oprobst/compressor-monitor/Dokumentation/Füllanlage-legende.png

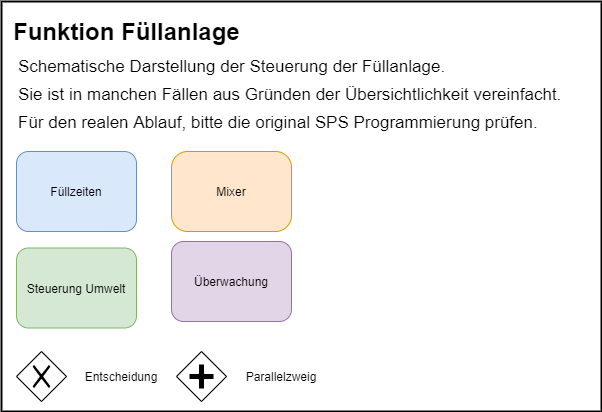
Dokumentation/Füllanlage-legende.png
