oprobst/compressor-monitor/Dokumentation/Füllanlage-steuerung.png

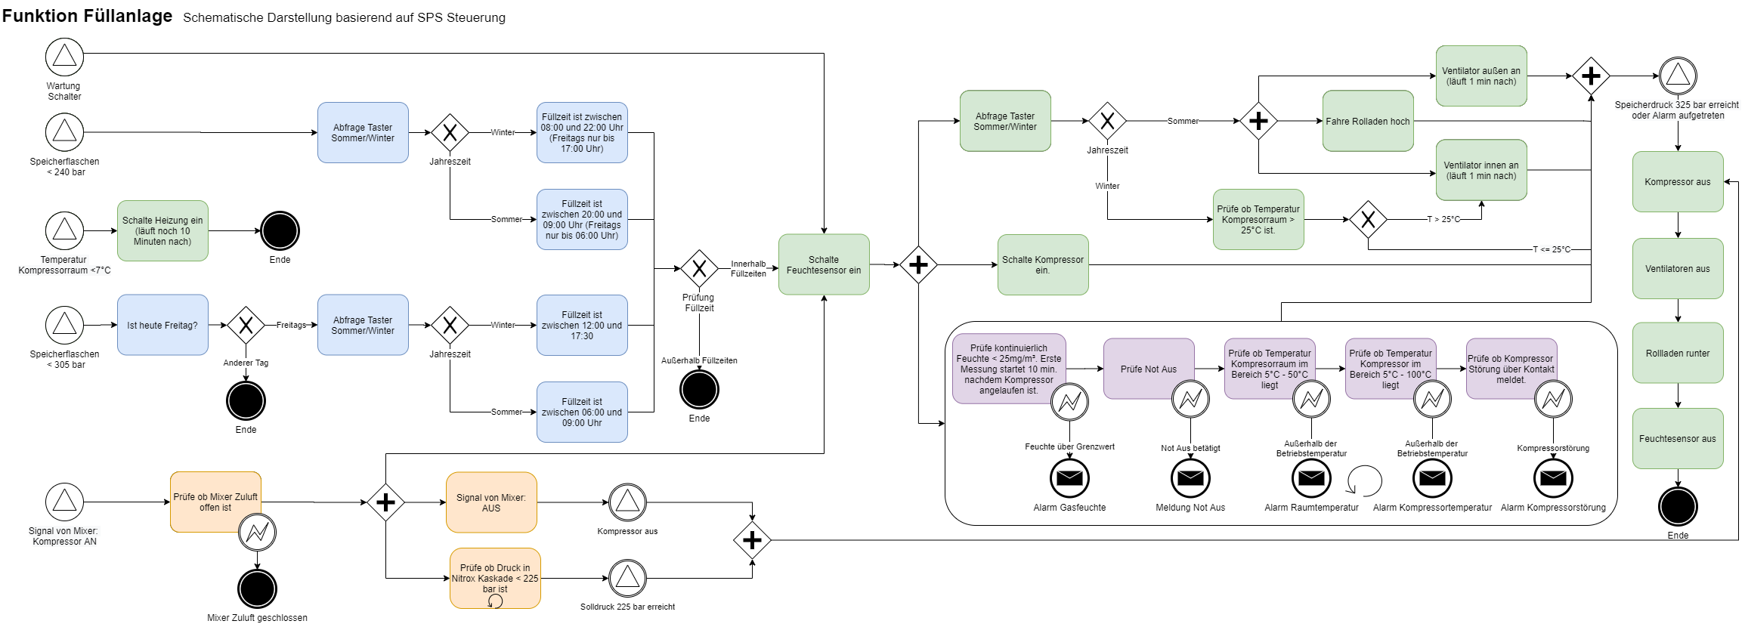
Dokumentation/Füllanlage-steuerung.png
