oprobst/compressor-monitor/Dokumentation/Schaltplan-Kompressor-Abschaltung.png

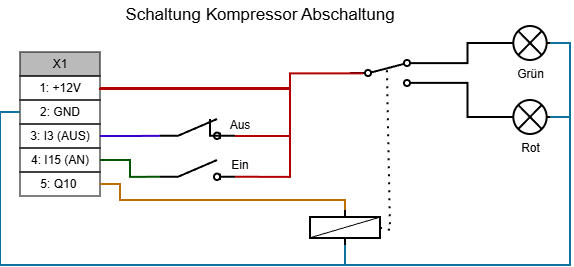
Dokumentation/Schaltplan-Kompressor-Abschaltung.png
