oprobst/compressor-monitor/Dokumentation/Schaltplan_Steuereinheit.drawio.png

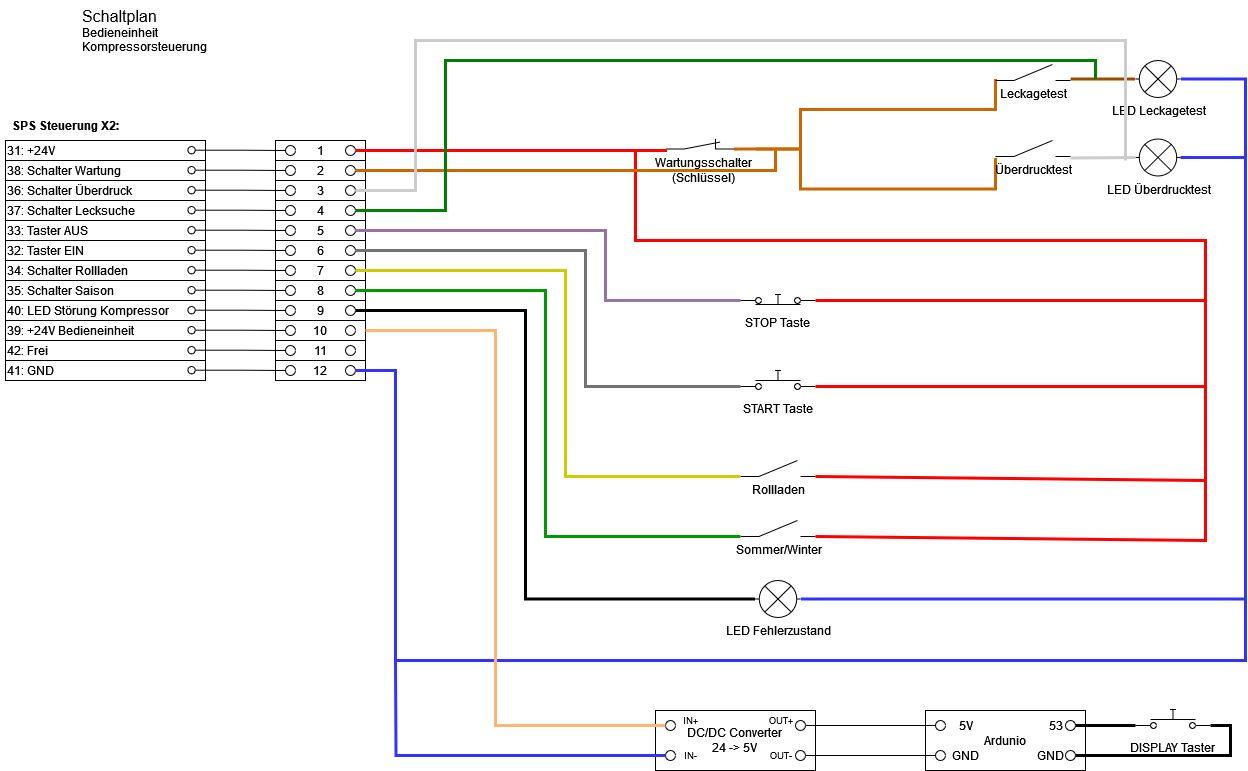
Dokumentation/Schaltplan_Steuereinheit.drawio.png
