oprobst/compressor-monitor/Dokumentation/Stromlaufplan_Logo_Kompressor.pdf

1 | 2 | 3 | 4 | 5 | 6 | 7 | 8

# Projektbezeichnung

# Firma

# Vereinsheim Malsch UV 'Siemens Logo!8'

# - privat -

# Verteilerdokumentation

# Zeichnungsnummer 1011

Projektadresse Tauchsportverein Malsch e.V.

# Letzte Änderung 08.01.2024

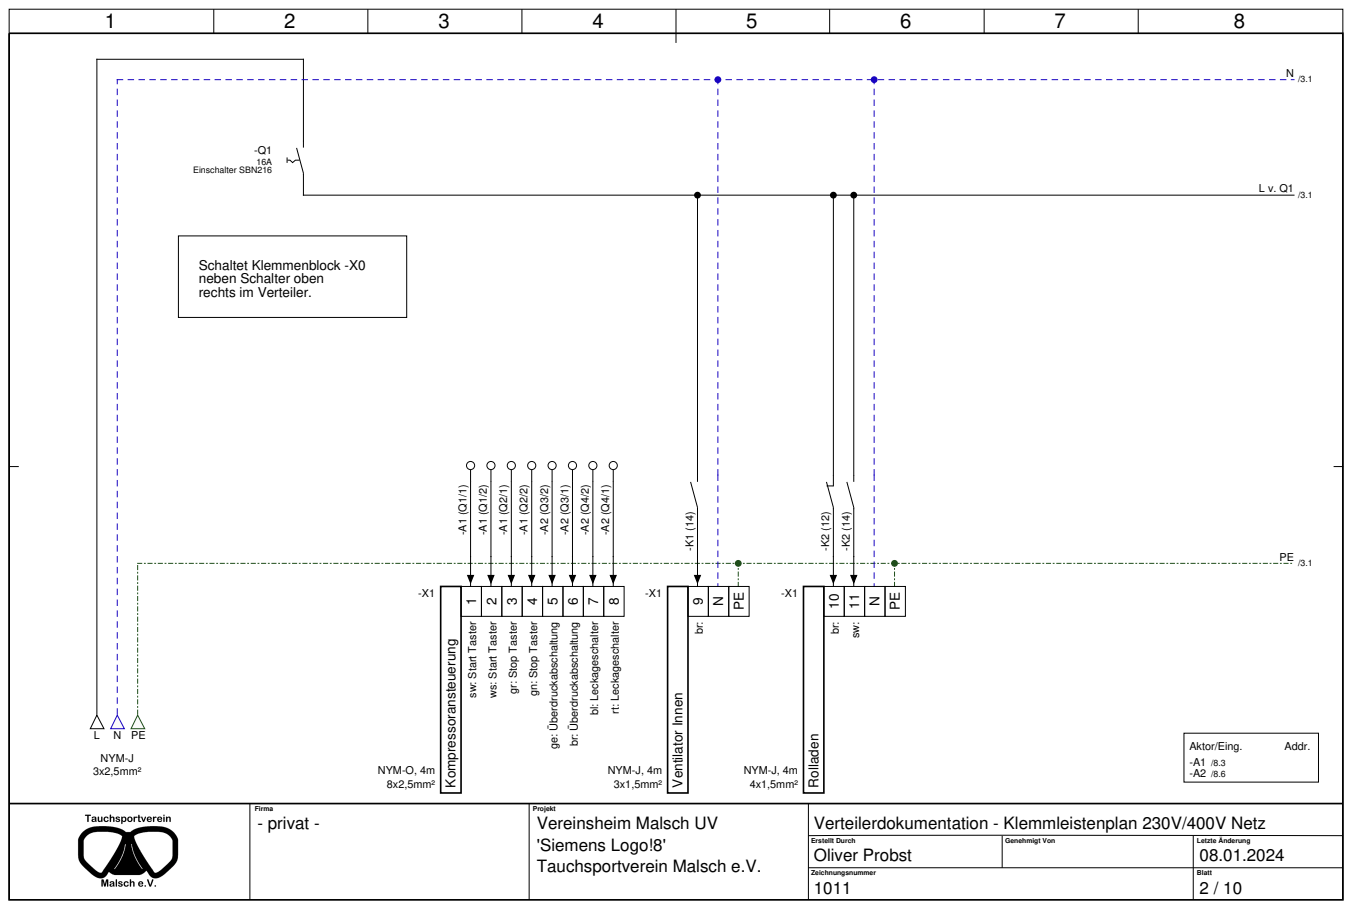
[picture p7: page 2]
Firma; Projekt; Erstellt Durch; Genehmigt Von; Letzte Änderung; Zeichnungsnummer; Vereinsheim Malsch UV; Verteilerdokumentation - Klemmleistenplan 230V/400V Netz; 'Siemens Logo!8'; Tauchsportverein Malsch e.V.; Blatt; Oliver Probst; - privat -; NYM-J 3x2,5mm²; -Q1 16A Einschalter SBN216; Kompressoransteuerung; NYM-O, 4m 8x2,5mm²; 5 ge: Überdruckabschaltung; 6 br: Überdruckabschaltung; 7 bl: Leckageschalter; 8 rt: Leckageschalter; Ventilator Innen; NYM-J, 4m 3x1,5mm²; Rolladen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

Schaltet Klemmenblock -X0
neben Schalter oben
rechts im Verteiler.

1 sw: Start Taster

2 ws: Start Taster

3 gr: Stop Taster

4 gn: Stop Taster

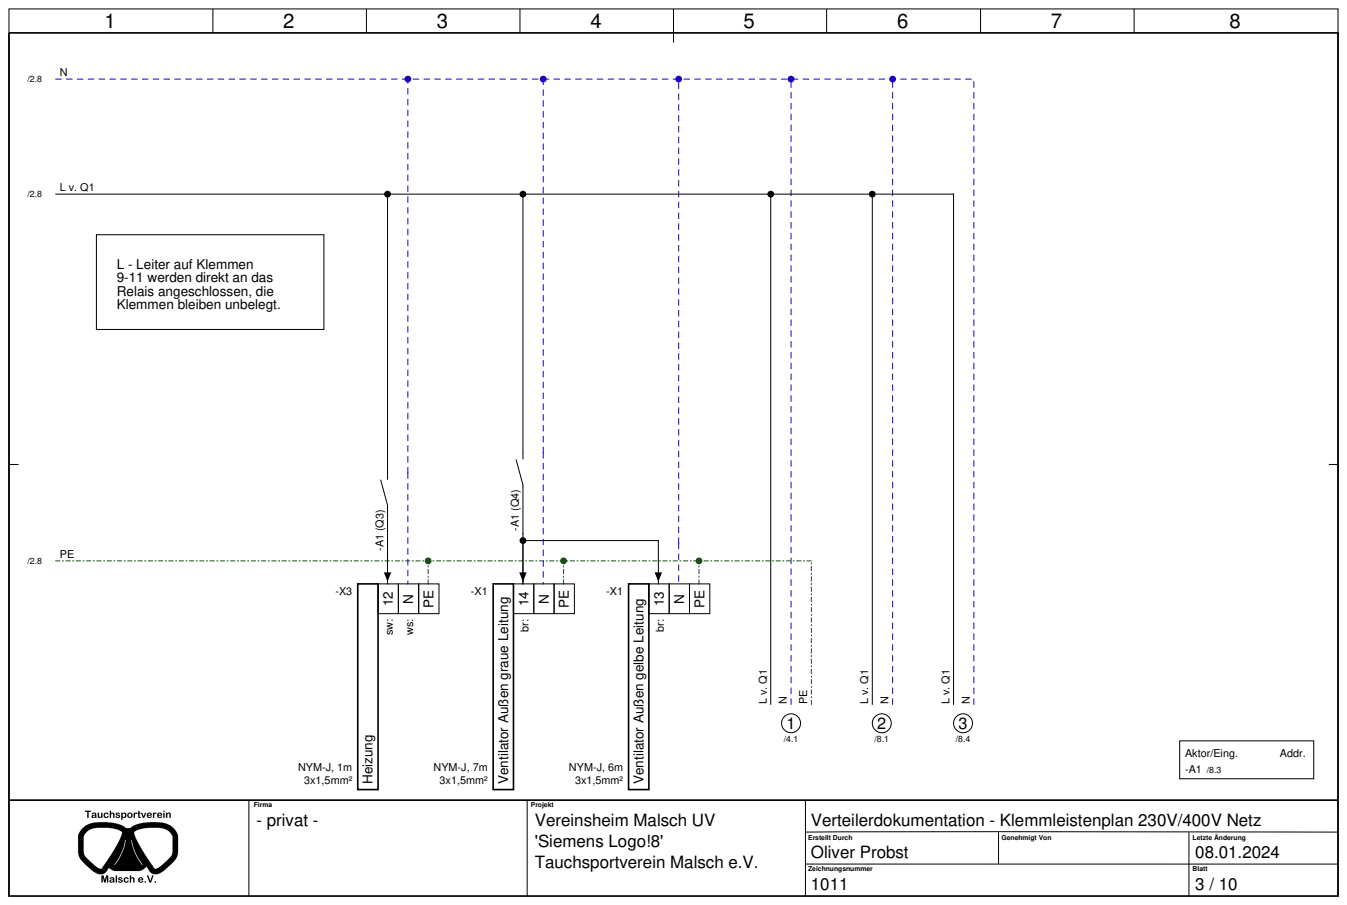
[picture p8: page 3]
Firma; Projekt; Erstellt Durch; Genehmigt Von; Letzte Änderung; Vereinsheim Malsch UV; Verteilerdokumentation - Klemmleistenplan 230V/400V Netz; 'Siemens Logo!8'; Oliver Probst; - privat -; Heizung; NYM-J, 1m 3x1,5mm²; NYM-J, 7m 3x1,5mm²; NYM-J, 6m 3x1,5mm²; Aktor/Eing.; Addr.

L - Leiter auf Klemmen
9-11 werden direkt an das
Relais angeschlossen, die
Klemmen bleiben unbelegt.

Ventilator Außen graue Leitung

Ventilator Außen gelbe Leitung

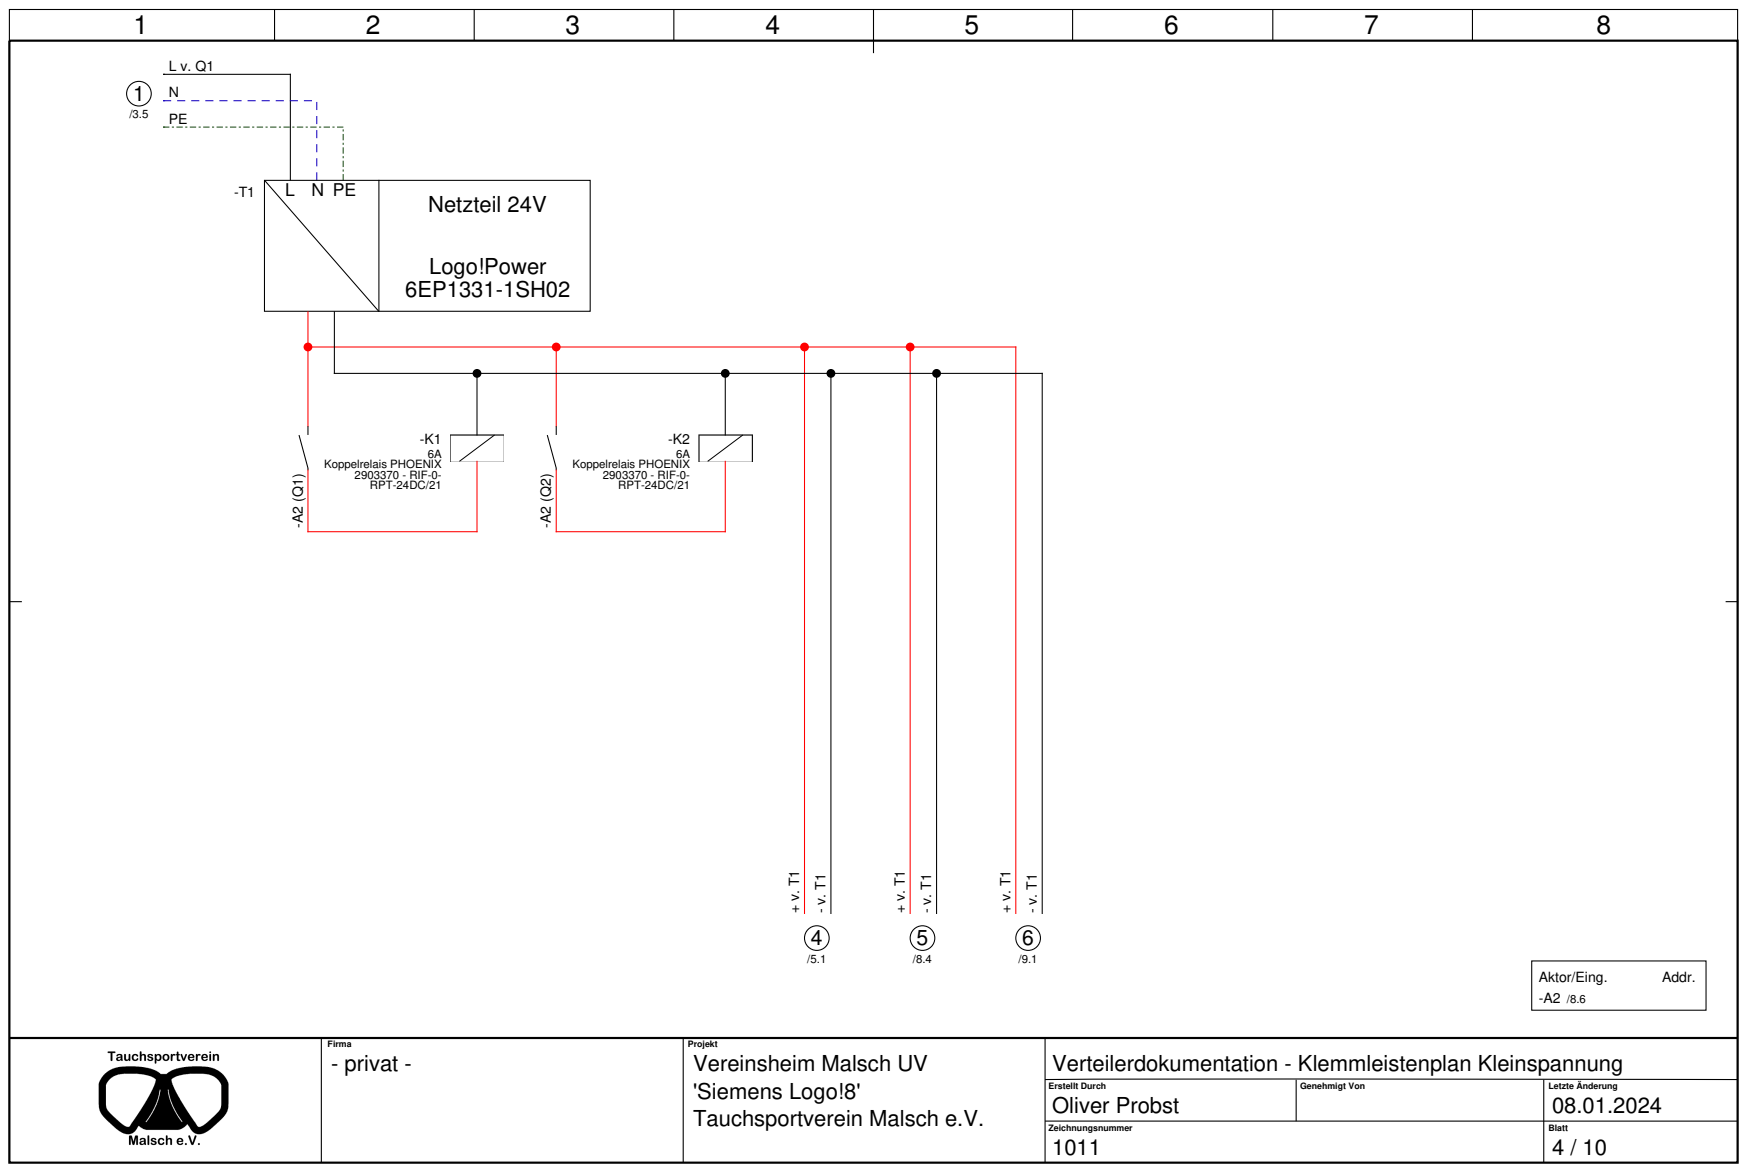
[picture p9: page 4]
Firma; Projekt; Erstellt Durch; Genehmigt Von; Letzte Änderung; Vereinsheim Malsch UV; Verteilerdokumentation - Klemmleistenplan Kleinspannung; 'Siemens Logo!8'; Oliver Probst; - privat -; Netzteil 24V; Logo!Power; -K1 6A Koppelrelais PHOENIX 2903370 - RIF-0- RPT-24DC/21; -K2 6A Koppelrelais PHOENIX 2903370 - RIF-0- RPT-24DC/21; Aktor/Eing.; Addr.

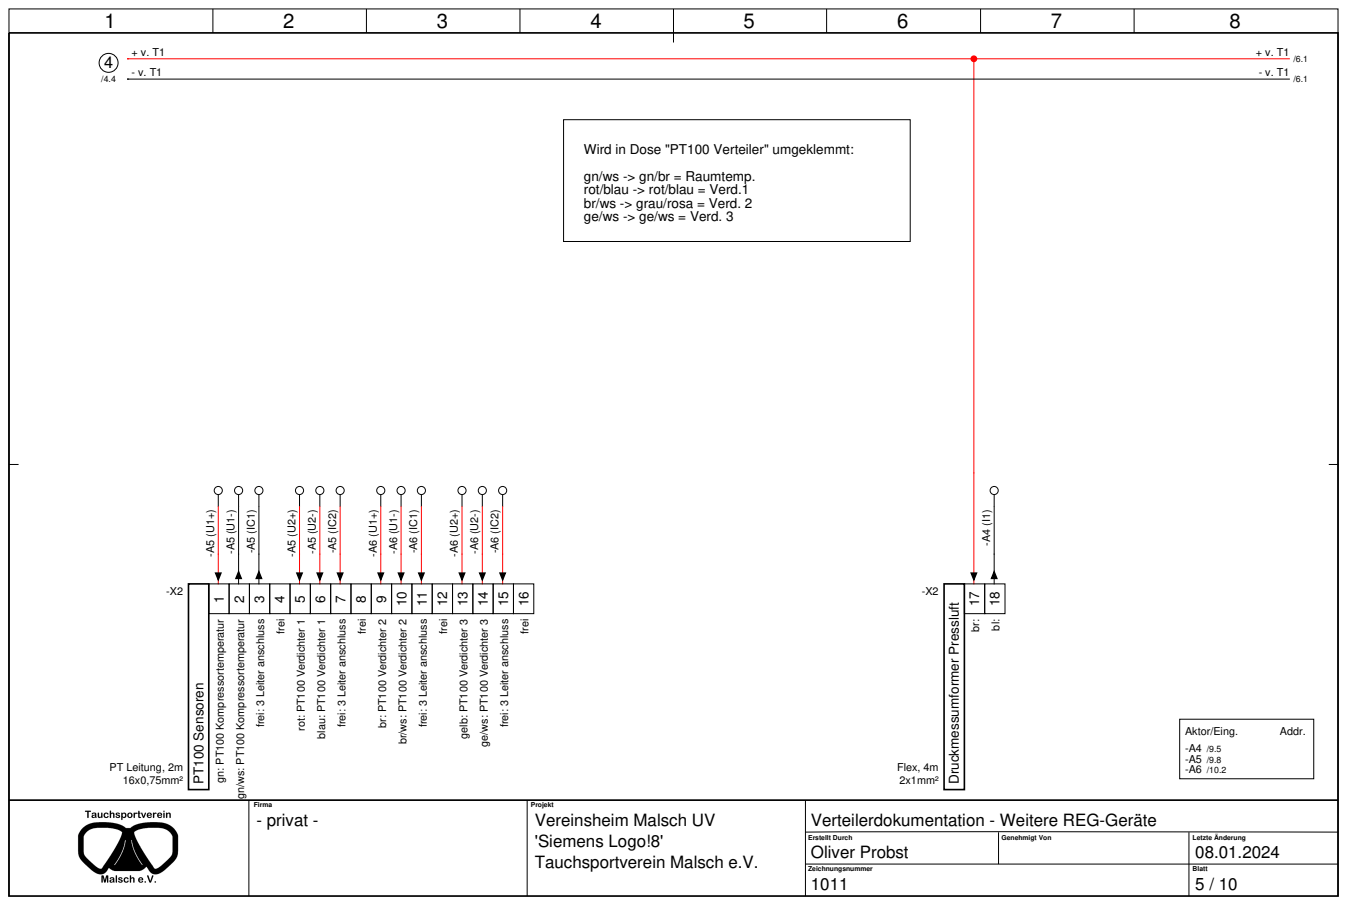
[picture p10: page 5]
Firma; Projekt; Erstellt Durch; Genehmigt Von; Letzte Änderung; Vereinsheim Malsch UV; Verteilerdokumentation - Weitere REG-Geräte; 'Siemens Logo!8'; Oliver Probst; - privat -; - v. T1 PT100 Sensoren; PT Leitung, 2m 16x0,75mm²; 1 gn: PT100 Kompressortemperatur; 4 frei; 5 rot: PT100 Verdichter 1; 6 blau: PT100 Verdichter 1; 8 frei; 9 br: PT100 Verdichter 2; 12 frei; 13 gelb: PT100 Verdichter 3; 16 frei; Druckmessumformer Pressluft; Flex, 4m 2x1mm²; Aktor/Eing.; Addr.

Wird in Dose "PT100 Verteiler" umgeklemmt:

gn/ws -> gn/br = Raumtemp.
rot/blau -> rot/blau = Verd.1
br/ws -> grau/rosa = Verd. 2
ge/ws -> ge/ws = Verd. 3

10 br/ws: PT100 Verdichter 2

11 frei: 3 Leiter anschluss

14 ge/ws: PT100 Verdichter 3

15 frei: 3 Leiter anschluss

2 gn/ws: PT100 Kompressortemperatur

3 frei: 3 Leiter anschluss

7 frei: 3 Leiter anschluss

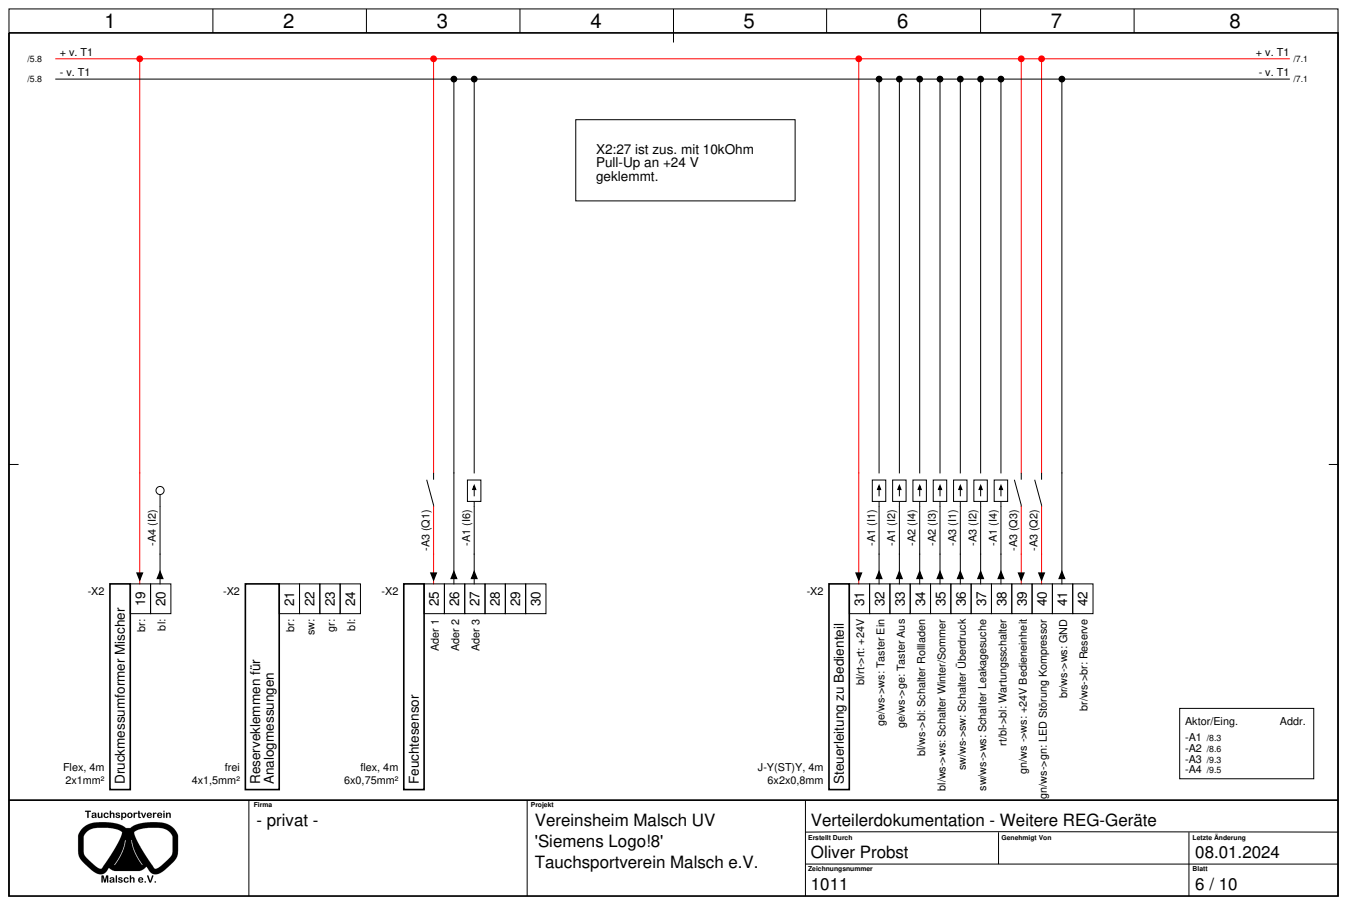
[picture p11: page 6]
Firma; Projekt; Erstellt Durch; Genehmigt Von; Letzte Änderung; Vereinsheim Malsch UV; Verteilerdokumentation - Weitere REG-Geräte; 'Siemens Logo!8'; Oliver Probst; - privat -; - v. T1 Druckmessumformer Mischer; Flex, 4m 2x1mm²; Reserveklemmen für; Analogmessungen; frei 4x1,5mm²; Feuchtesensor; flex, 4m 6x0,75mm²; 25 Ader 1; 26 Ader 2; 27 Ader 3; Aktor/Eing.; Addr.

X2:27 ist zus. mit 10kOhm
Pull-Up an +24 V
geklemmt.

32 ge/ws->ws: Taster Ein

33 ge/ws->ge: Taster Aus

34 bl/ws->bl: Schalter Rollladen

35 bl/ws->ws: Schalter Winter/Sommer

36 sw/ws->sw: Schalter Überdruck

37 sw/ws->ws: Schalter Leakagesuche

38 rt/bl->bl: Wartungsschalter

39 gn/ws ->ws: +24V Bedieneinheit

40 gn/ws->gn: LED Störung Kompressor

41 br/ws->ws: GND

42 br/ws->br: Reserve

Steuerleitung zu Bedienteil

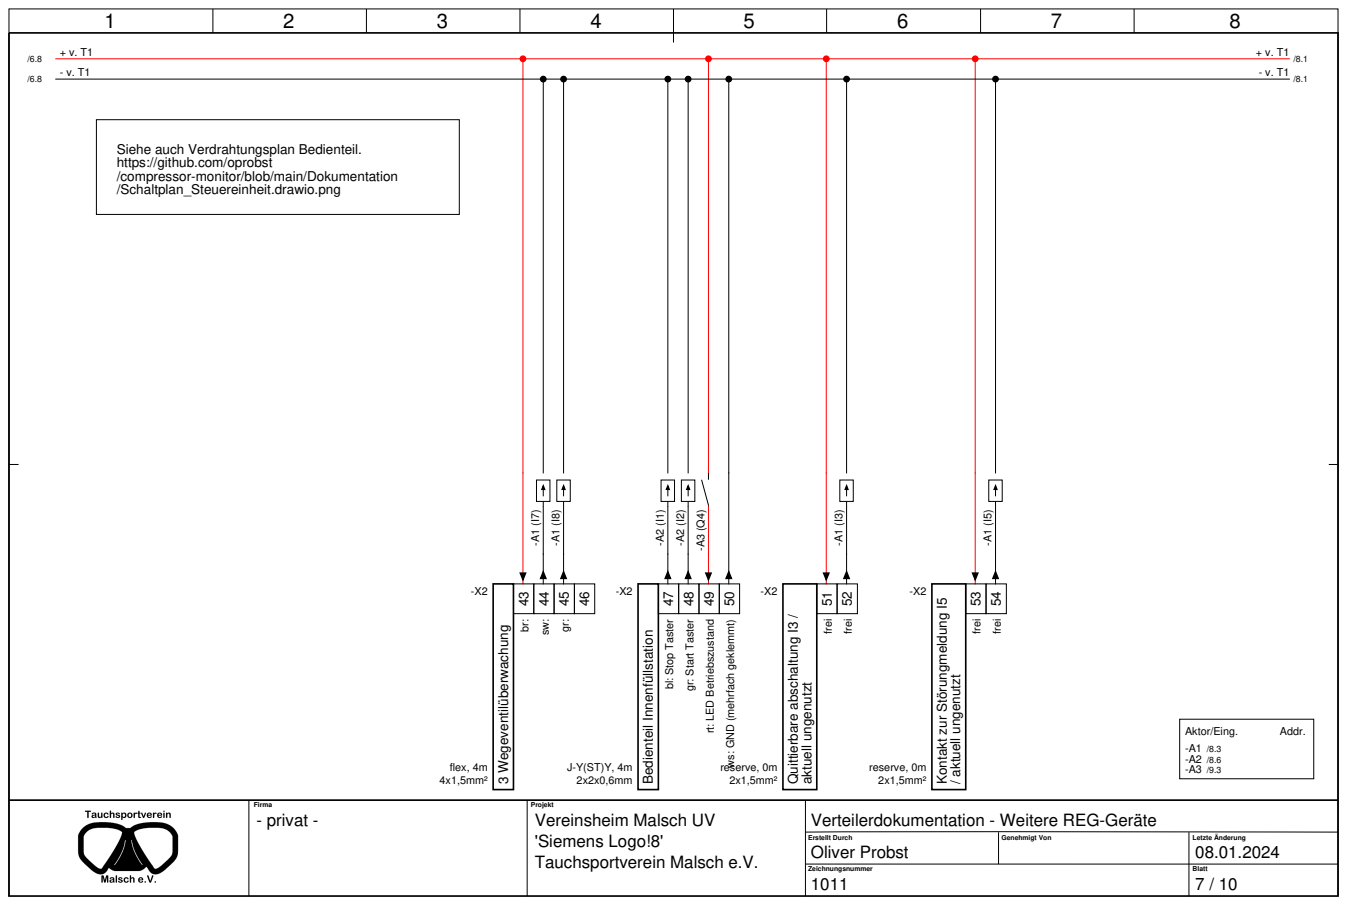
[picture p12: page 7]
Firma; Projekt; Erstellt Durch; Genehmigt Von; Letzte Änderung; Vereinsheim Malsch UV; Verteilerdokumentation - Weitere REG-Geräte; 'Siemens Logo!8'; Oliver Probst; - privat -; 3 Wegeventilüberwachung; flex, 4m 4x1,5mm²; Bedienteil Innenfüllstation; Quittierbare abschaltung I3 /; aktuell ungenutzt; reserve, 0m 2x1,5mm²; 51 frei; 52 frei; / aktuell ungenutzt; 53 frei; 54 frei; Aktor/Eing.; Addr.

Siehe auch Verdrahtungsplan Bedienteil.
https://github.com/oprobst
/compressor-monitor/blob/main/Dokumentation
/Schaltplan_Steuereinheit.drawio.png

47 bl: Stop Taster

48 gr: Start Taster

49 rt: LED Betriebszustand

50 ws: GND (mehrfach geklemmt)

Kontakt zur Störungmeldung I5

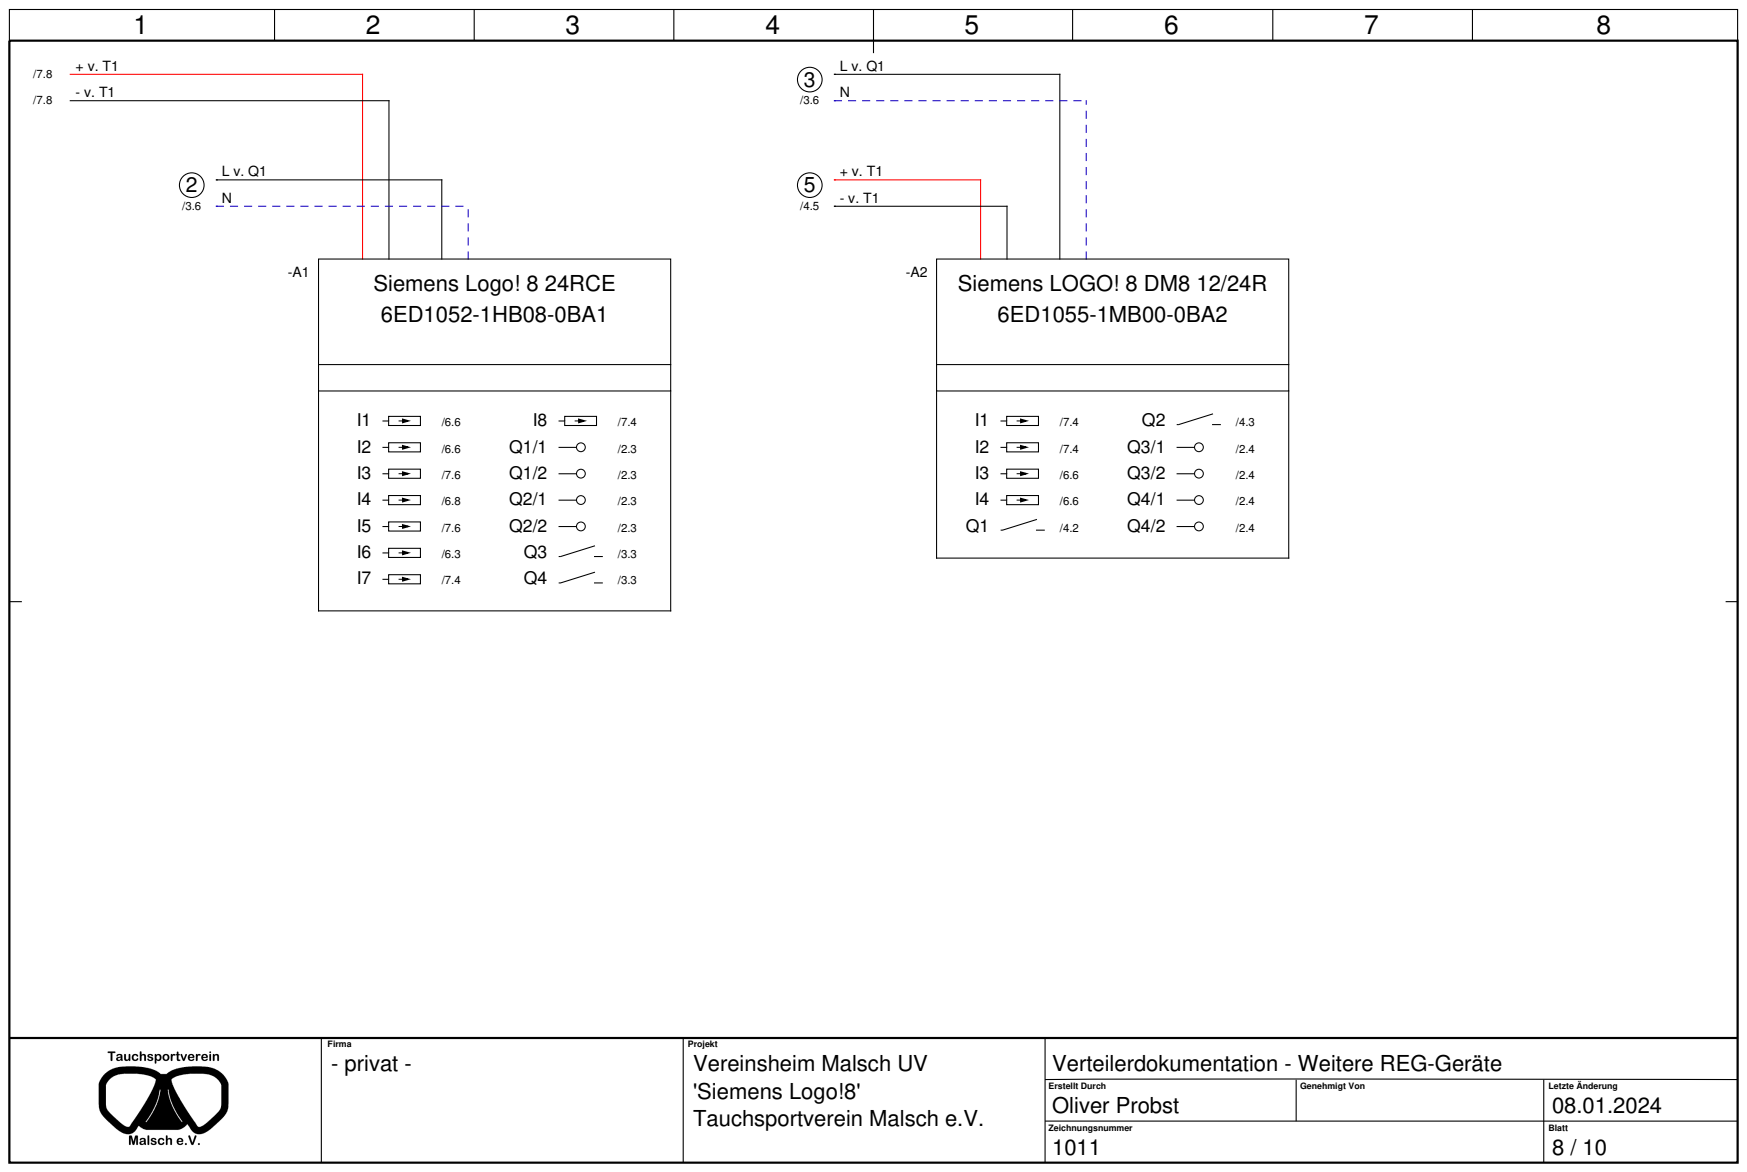
[picture p13: page 8]
Firma; Projekt; Erstellt Durch; Genehmigt Von; Letzte Änderung; Vereinsheim Malsch UV; Verteilerdokumentation - Weitere REG-Geräte; 'Siemens Logo!8'; Oliver Probst; - privat -; Siemens Logo! 8 24RCE 6ED1052-1HB08-0BA1; Siemens LOGO! 8 DM8 12/24R 6ED1055-1MB00-0BA2

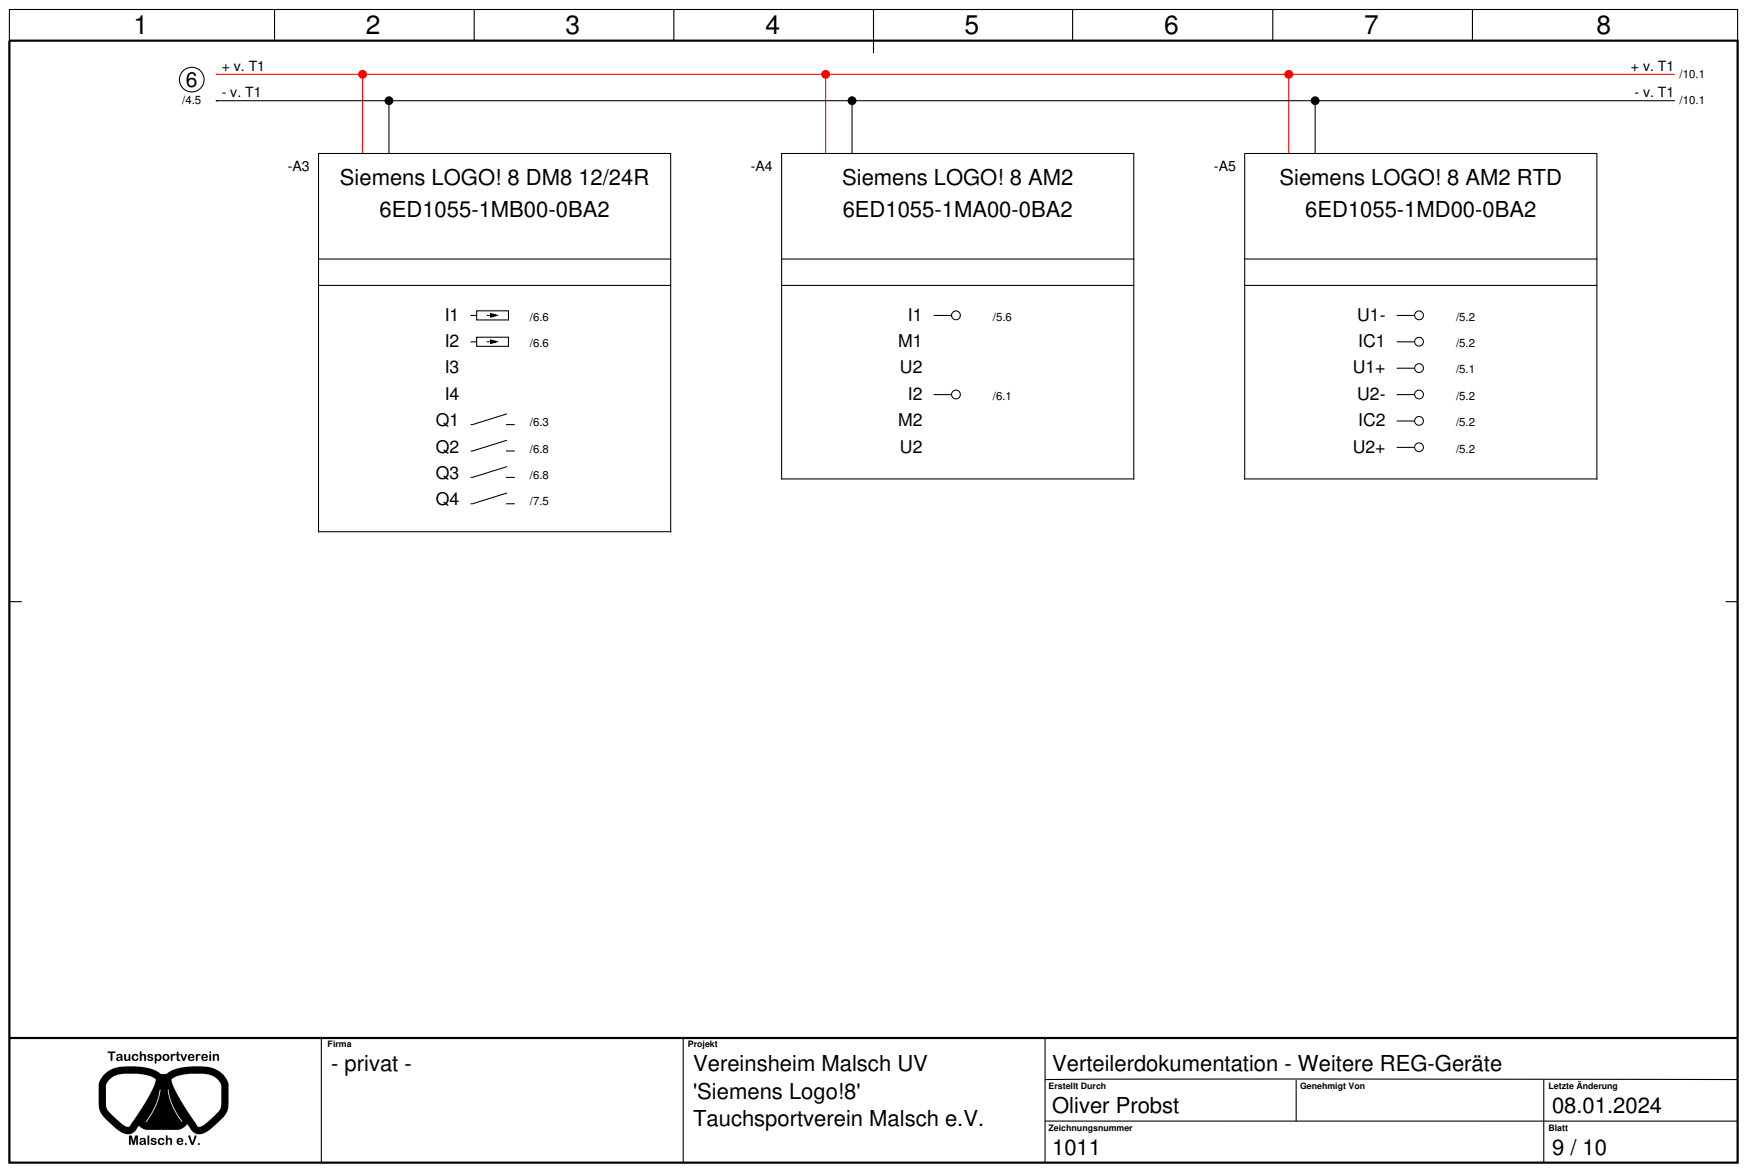
[picture p14: page 9]
Firma; Projekt; Erstellt Durch; Genehmigt Von; Letzte Änderung; Vereinsheim Malsch UV; Verteilerdokumentation - Weitere REG-Geräte; 'Siemens Logo!8'; Oliver Probst; - privat -; Siemens LOGO! 8 DM8 12/24R 6ED1055-1MB00-0BA2; Siemens LOGO! 8 AM2 6ED1055-1MA00-0BA2; Siemens LOGO! 8 AM2 RTD 6ED1055-1MD00-0BA2

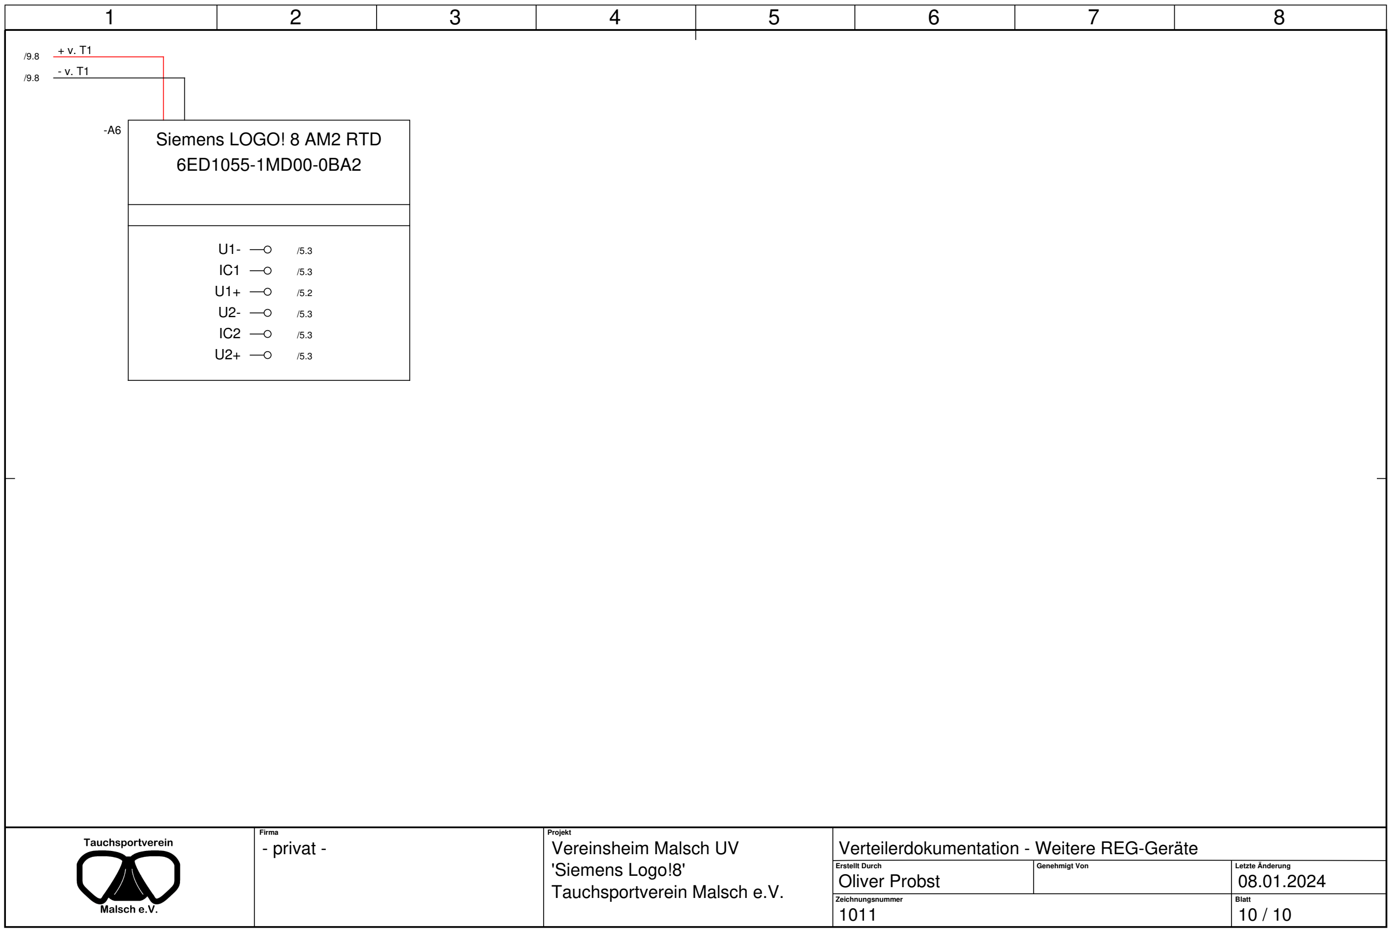
[picture p15: figure]
Firma; Projekt; Erstellt Durch; Genehmigt Von; Letzte Änderung; Vereinsheim Malsch UV; Verteilerdokumentation - Weitere REG-Geräte; 'Siemens Logo!8'; Oliver Probst; - privat -; Siemens LOGO! 8 AM2 RTD 6ED1055-1MD00-0BA2
