oprobst/compressor-monitor/Dokumentation/Füllanlage-Logik.PDF

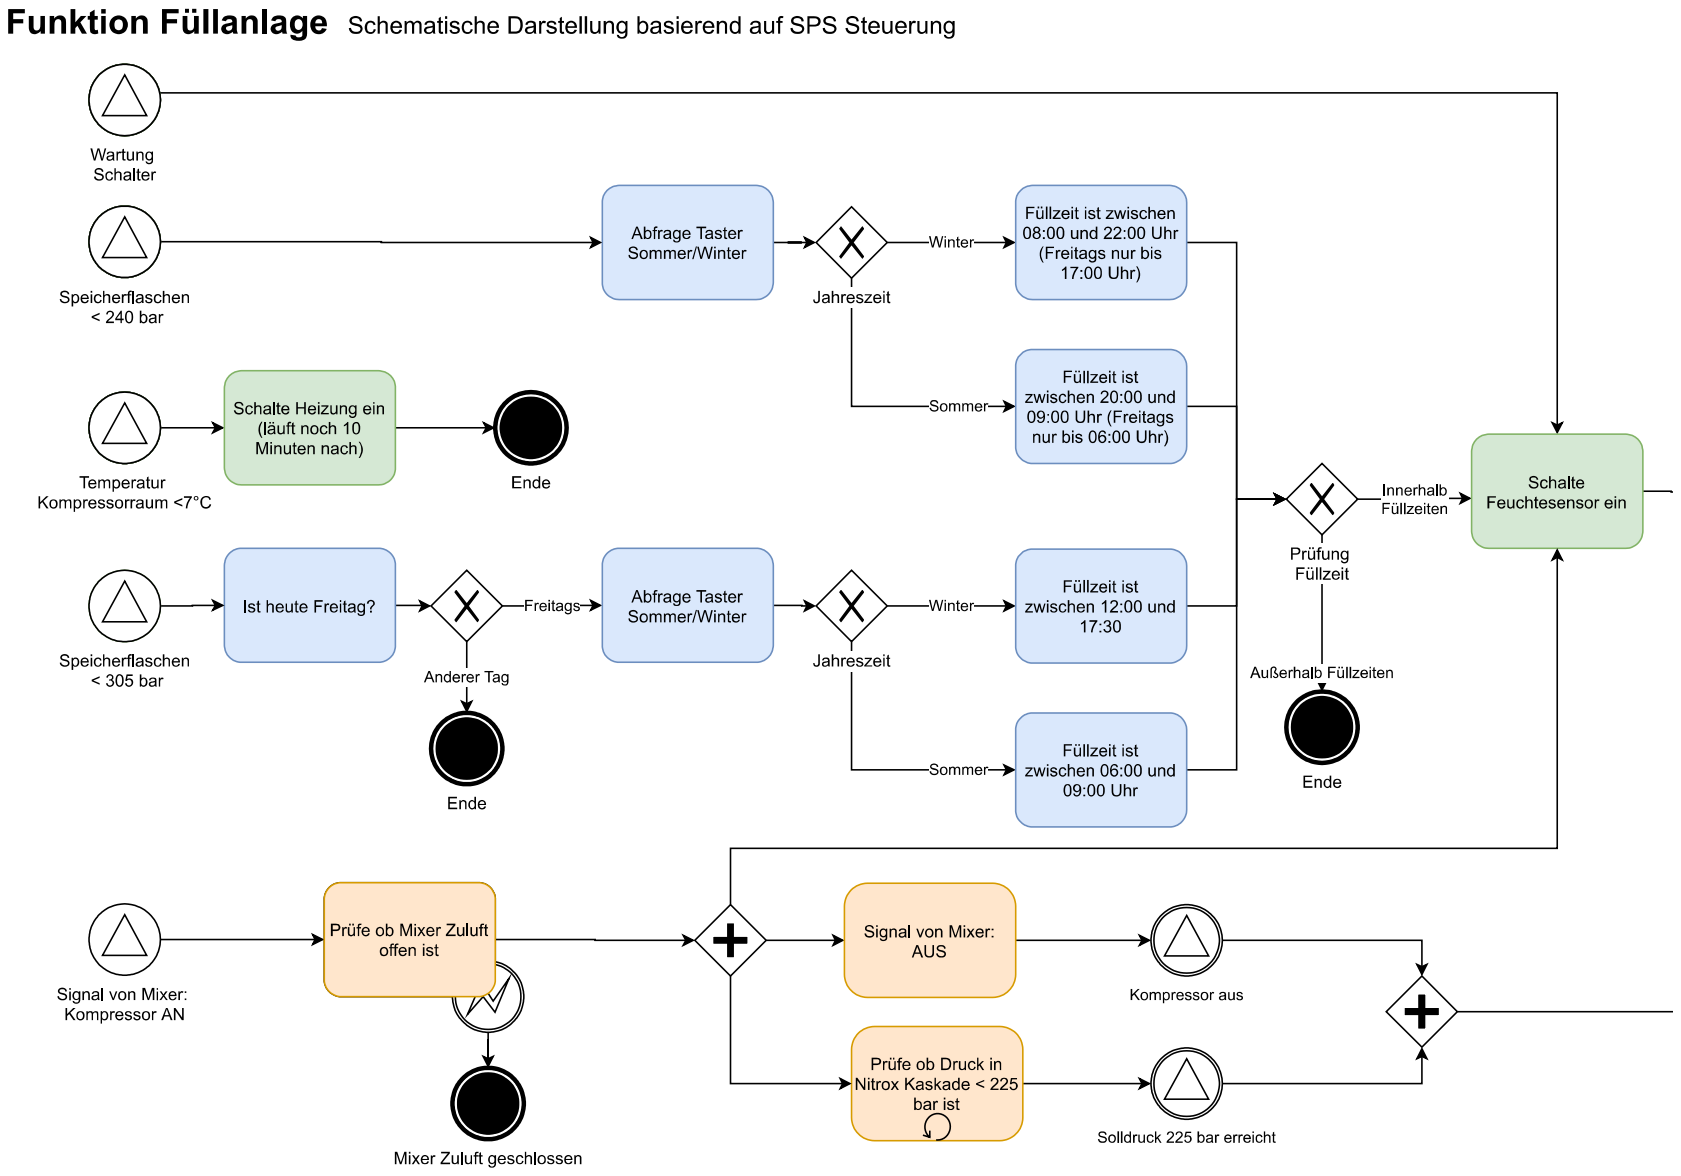
[picture p16: page 1]

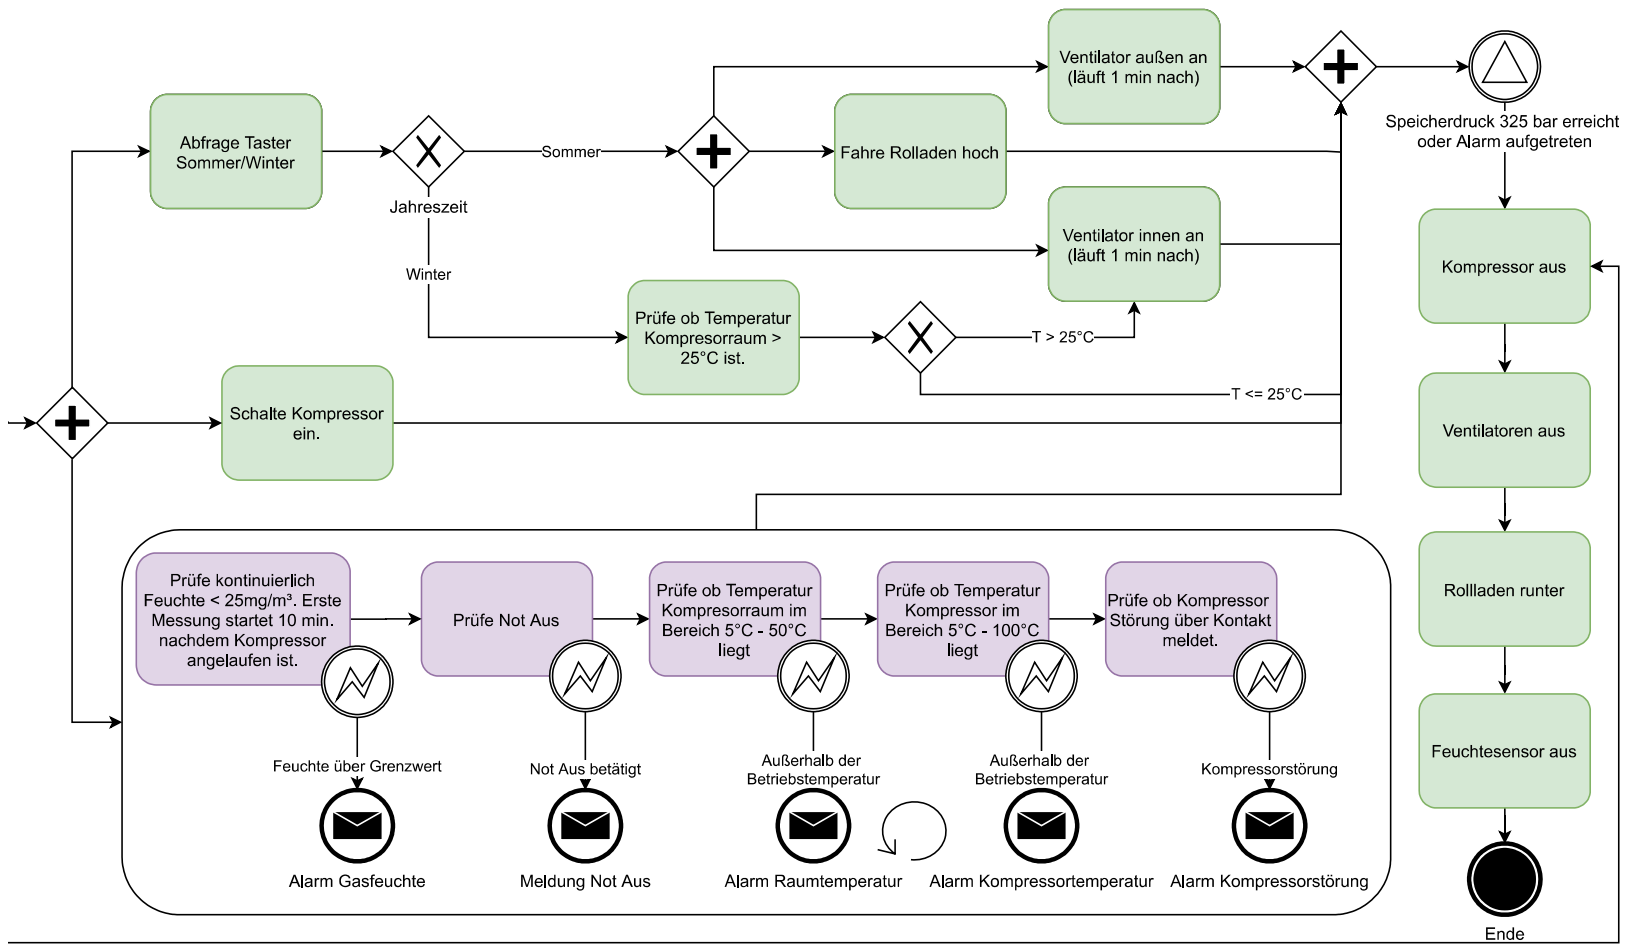
[picture p17: page 2]
