oprobst/compressor-monitor/Dokumentation/Füllanlage-steuerung.PDF

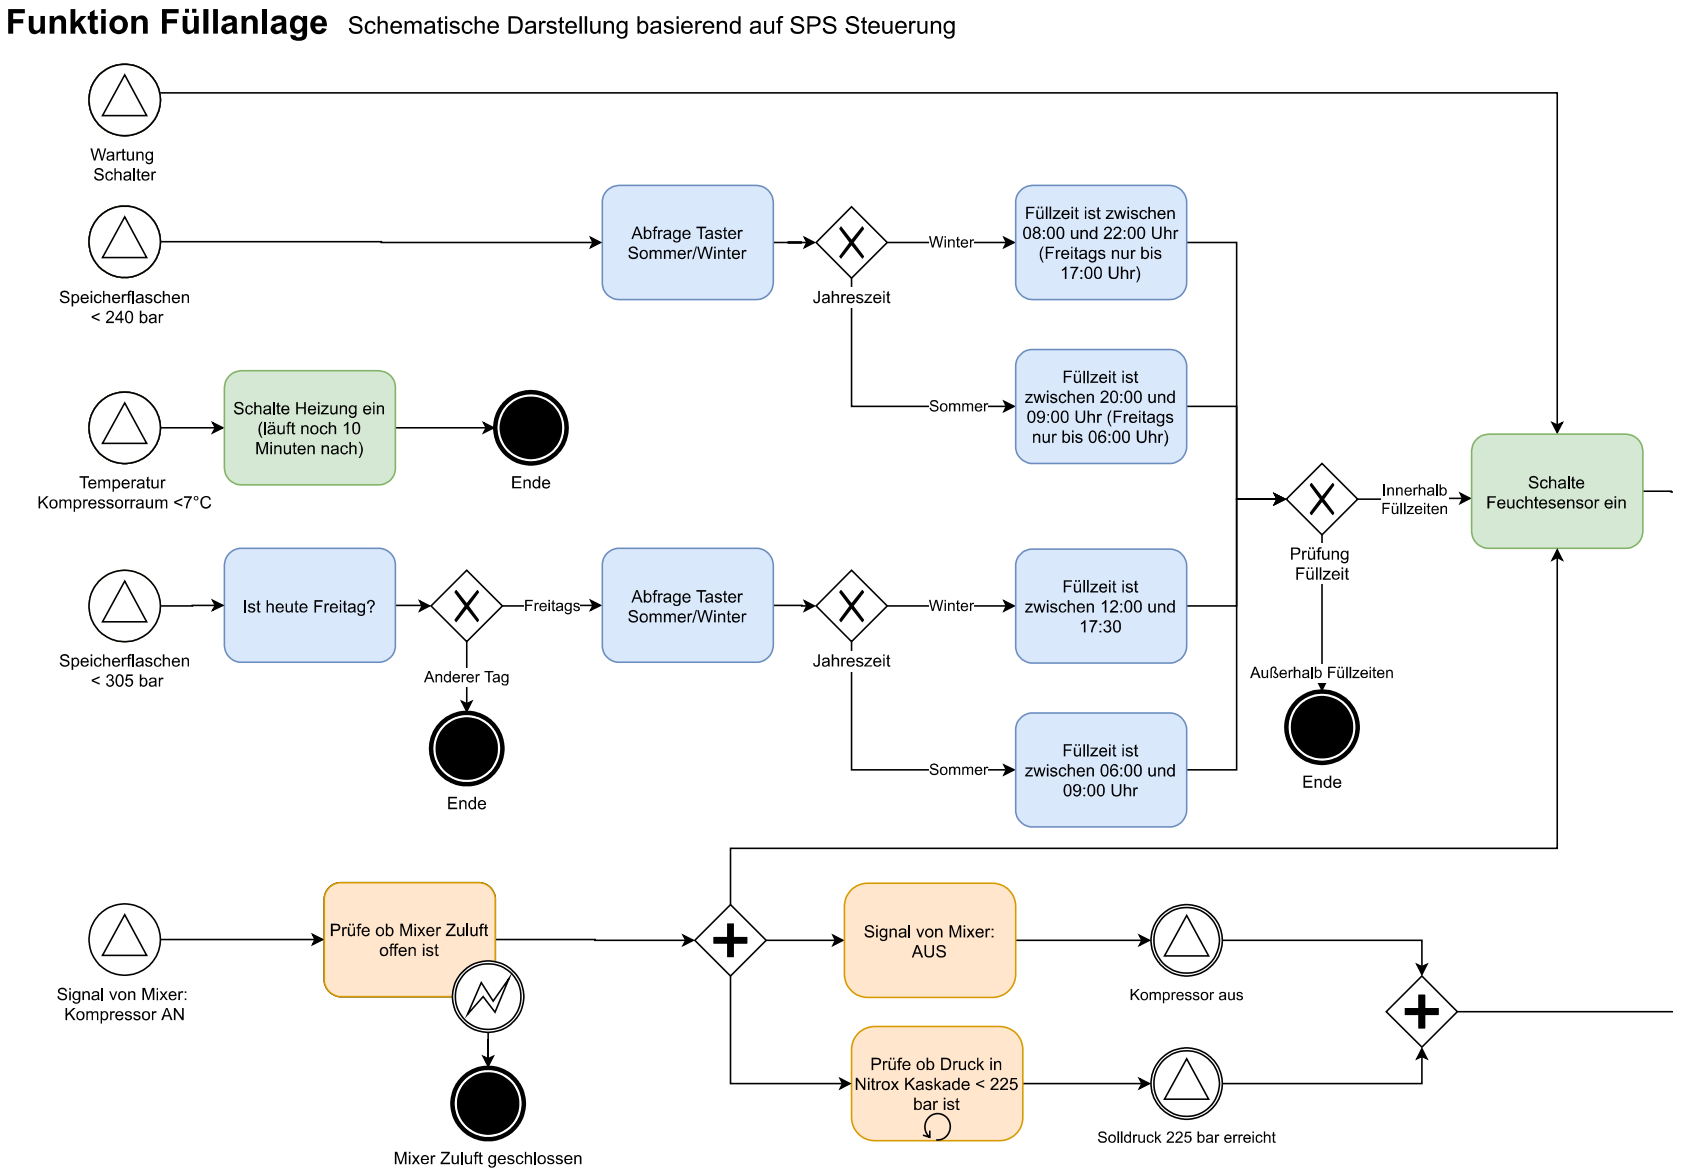
[picture p18: page 1]
