oprobst/compressor-monitor/kompressormonitor/SevenSegFont.h

/*
Software License Agreement (BSD License)

Copyright (c) 2012 Adafruit Industries.  All rights reserved.

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
- Redistributions of source code must retain the above copyright notice,
  this list of conditions and the following disclaimer.
- Redistributions in binary form must reproduce the above copyright notice,
  this list of conditions and the following disclaimer in the documentation
  and/or other materials provided with the distribution.

THIS SOFTWARE IS PROVIDED BY THE COPYRIGHT HOLDERS AND CONTRIBUTORS "AS IS"
AND ANY EXPRESS OR IMPLIED WARRANTIES, INCLUDING, BUT NOT LIMITED TO, THE
IMPLIED WARRANTIES OF MERCHANTABILITY AND FITNESS FOR A PARTICULAR PURPOSE
ARE DISCLAIMED. IN NO EVENT SHALL THE COPYRIGHT HOLDER OR CONTRIBUTORS BE
LIABLE FOR ANY DIRECT, INDIRECT, INCIDENTAL, SPECIAL, EXEMPLARY, OR
CONSEQUENTIAL DAMAGES (INCLUDING, BUT NOT LIMITED TO, PROCUREMENT OF
SUBSTITUTE GOODS OR SERVICES; LOSS OF USE, DATA, OR PROFITS; OR BUSINESS
INTERRUPTION) HOWEVER CAUSED AND ON ANY THEORY OF LIABILITY, WHETHER IN
CONTRACT, STRICT LIABILITY, OR TORT (INCLUDING NEGLIGENCE OR OTHERWISE)
ARISING IN ANY WAY OUT OF THE USE OF THIS SOFTWARE, EVEN IF ADVISED OF THE
POSSIBILITY OF SUCH DAMAGE.
*/

/* Base on https://github.com/prenticedavid/MCUFRIEND_kbv/blob/master/FreeSevenSegNumFontPlusPlus.h */

const uint8_t SevenSegFontBitmaps[] PROGMEM = {
  0x00, 0x00, 0x00, 0x1F, 0xFF, 0xF0, 0x3F, 0xFF, 0xFC, 0xFF, 0xFF, 0xFF, 
  0x7F, 0xFF, 0xFE, 0x1F, 0xFF, 0xF8, 0x00, 0x00, 0x00, 0x38, 0xFB, 0xFF, 
  0xFF, 0xEF, 0x8E, 0x00, 0x03, 0xFF, 0xF8, 0x00, 0xFF, 0xFF, 0x80, 0x3F, 
  0xFF, 0xF8, 0x03, 0xFF, 0xFE, 0xC3, 0x3F, 0xFF, 0xBC, 0xF0, 0x00, 0x0F, 
  0xFF, 0x00, 0x01, 0xFF, 0xE0, 0x00, 0x3F, 0xFC, 0x00, 0x07, 0xFF, 0x80, 
  0x00, 0xFF, 0xF0, 0x00, 0x1F, 0xFE, 0x00, 0x03, 0xFF, 0xC0, 0x00, 0x7F, 
  0xF8, 0x00, 0x0F, 0xFF, 0x00, 0x01, 0xFF, 0xE0, 0x00, 0x3F, 0xFC, 0x00, 
  0x07, 0xFF, 0x80, 0x00, 0xFF, 0xF0, 0x00, 0x1F, 0xFC, 0x00, 0x00, 0xFE, 
  0x00, 0x00, 0x07, 0x00, 0x00, 0x00, 0x40, 0x00, 0x00, 0x04, 0x00, 0x00, 
  0x00, 0xE0, 0x00, 0x00, 0x7F, 0x00, 0x00, 0x3F, 0xF0, 0x00, 0x1F, 0xFE, 
  0x00, 0x03, 0xFF, 0xC0, 0x00, 0x7F, 0xF8, 0x00, 0x0F, 0xFF, 0x00, 0x01, 
  0xFF, 0xE0, 0x00, 0x3F, 0xFC, 0x00, 0x07, 0xFF, 0x80, 0x00, 0xFF, 0xF0, 
  0x00, 0x1F, 0xFE, 0x00, 0x03, 0xFF, 0xC0, 0x00, 0x7F, 0xF8, 0x00, 0x0F, 
  0xFF, 0x00, 0x01, 0xFF, 0xE0, 0x00, 0x3F, 0x78, 0x00, 0x03, 0xC6, 0x7F, 
  0xFF, 0x30, 0x1F, 0xFF, 0xF0, 0x07, 0xFF, 0xFF, 0x00, 0x7F, 0xFF, 0xC0, 
  0x07, 0xFF, 0xF0, 0x00, 0x31, 0xEF, 0xFF, 0xFF, 0xFF, 0xFF, 0xFF, 0xFF, 
  0xFF, 0xFF, 0xFF, 0xFF, 0x3C, 0x30, 0x40, 0x00, 0x33, 0xFF, 0xFF, 0xFF, 
  0xFF, 0xFF, 0xFF, 0xFF, 0xFF, 0xFF, 0xFF, 0xFD, 0xE3, 0x00, 0x03, 0xFF, 
  0xF8, 0x00, 0xFF, 0xFF, 0x80, 0x3F, 0xFF, 0xF8, 0x03, 0xFF, 0xFE, 0xC0, 
  0x3F, 0xFF, 0xBC, 0x00, 0x00, 0x0F, 0xC0, 0x00, 0x01, 0xF8, 0x00, 0x00, 
  0x3F, 0x00, 0x00, 0x07, 0xE0, 0x00, 0x00, 0xFC, 0x00, 0x00, 0x1F, 0x80, 
  0x00, 0x03, 0xF0, 0x00, 0x00, 0x7E, 0x00, 0x00, 0x0F, 0xC0, 0x00, 0x01, 
  0xF8, 0x00, 0x00, 0x3F, 0x00, 0x00, 0x07, 0xE0, 0x00, 0x00, 0xFC, 0x00, 
  0x00, 0x1F, 0x80, 0x00, 0x00, 0xF0, 0x7F, 0xFF, 0x86, 0x1F, 0xFF, 0xFC, 
  0x4F, 0xFF, 0xFF, 0xE4, 0xFF, 0xFF, 0xF8, 0xE7, 0xFF, 0xFC, 0x1F, 0x00, 
  0x00, 0x03, 0xF0, 0x00, 0x00, 0x7E, 0x00, 0x00, 0x0F, 0xC0, 0x00, 0x01, 
  0xF8, 0x00, 0x00, 0x3F, 0x00, 0x00, 0x07, 0xE0, 0x00, 0x00, 0xFC, 0x00, 
  0x00, 0x1F, 0x80, 0x00, 0x03, 0xF0, 0x00, 0x00, 0x7E, 0x00, 0x00, 0x0F, 
  0xC0, 0x00, 0x01, 0xF8, 0x00, 0x00, 0x3F, 0x00, 0x00, 0x07, 0xE0, 0x00, 
  0x00, 0x78, 0x00, 0x00, 0x06, 0x7F, 0xFF, 0x00, 0x1F, 0xFF, 0xF0, 0x07, 
  0xFF, 0xFF, 0x00, 0x7F, 0xFF, 0xC0, 0x07, 0xFF, 0xF0, 0x00, 0x0F, 0xFF, 
  0xE0, 0x0F, 0xFF, 0xF8, 0x0F, 0xFF, 0xFE, 0x03, 0xFF, 0xFE, 0xC0, 0xFF, 
  0xFE, 0xF0, 0x00, 0x00, 0xFC, 0x00, 0x00, 0x7E, 0x00, 0x00, 0x3F, 0x00, 
  0x00, 0x1F, 0x80, 0x00, 0x0F, 0xC0, 0x00, 0x07, 0xE0, 0x00, 0x03, 0xF0, 
  0x00, 0x01, 0xF8, 0x00, 0x00, 0xFC, 0x00, 0x00, 0x7E, 0x00, 0x00, 0x3F, 
  0x00, 0x00, 0x1F, 0x80, 0x00, 0x0F, 0xC0, 0x00, 0x07, 0xE0, 0x00, 0x00, 
  0xF1, 0xFF, 0xFE, 0x19, 0xFF, 0xFF, 0xC7, 0xFF, 0xFF, 0xF8, 0xFF, 0xFF, 
  0xF8, 0x1F, 0xFF, 0xF1, 0x80, 0x00, 0x03, 0xC0, 0x00, 0x07, 0xE0, 0x00, 
  0x03, 0xF0, 0x00, 0x01, 0xF8, 0x00, 0x00, 0xFC, 0x00, 0x00, 0x7E, 0x00, 
  0x00, 0x3F, 0x00, 0x00, 0x1F, 0x80, 0x00, 0x0F, 0xC0, 0x00, 0x07, 0xE0, 
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
};

const GFXglyph SevenSegFontGlyphs[] PROGMEM = {
  {     0,  24,   7,  32,    4,  -28 },   // 0x2D '-'
  {    21,   7,   7,  32,   14,  -12 },   // 0x2E '.'
  {    28,   0,   0,  32,   32,  -50 },   // 0x2F '/'
  {    28,  27,  46,  32,    2,  -48 },   // 0x30 '0'
  {   184,   6,  39,  32,   23,  -45 },   // 0x31 '1'
  {   214,  27,  46,  32,    2,  -48 },   // 0x32 '2'
  {   370,  25,  46,  32,    4,  -48 },   // 0x33 '3'
  {   514,  27,  39,  32,    2,  -45 },   // 0x34 '4'
  {   646,  27,  46,  32,    2,  -48 },   // 0x35 '5'
  {   802,  27,  46,  32,    2,  -48 },   // 0x36 '6'
  {   958,  23,  42,  32,    6,  -48 },   // 0x37 '7'
  {  1079,  27,  46,  32,    2,  -48 },   // 0x38 '8'
  {  1235,  27,  46,  32,    2,  -48 },   // 0x39 '9'
  {  1391,   7,  28,  32,   14,  -38 },   // 0x3A ':'
  {  1407,  27,  46,  32,    2,  -48 }    // 0x3B ';'
};

const GFXfont SevenSegFont PROGMEM = {
    (uint8_t  *)SevenSegFontBitmaps, 
    (GFXglyph *)SevenSegFontGlyphs, 0x2D, 0x3B,  50
};
// FreeSevenSegNumFontPlusPlus bitmap size = 1395 [1525] [2617]
