oprobst/compressor-monitor/kompressormonitor/DegreeFont.h

const uint8_t DegreeFontBitmaps[] PROGMEM = {
  0x00, 0xFF, 0x00, 0x07, 0xFF, 0x80, 0x3F, 0xFF, 0xC0, 0xFF, 0xFF, 0xC3, 
  0xF8, 0x1F, 0x87, 0xE0, 0x1F, 0x9F, 0x80, 0x1F, 0x3E, 0x00, 0x1F, 0x7C, 
  0x00, 0x3E, 0xF0, 0x00, 0x03, 0xE0, 0x00, 0x07, 0xC0, 0x00, 0x0F, 0x00, 
  0x00, 0x1E, 0x00, 0x00, 0x3E, 0x00, 0x00, 0x7C, 0x00, 0x00, 0x78, 0x00, 
  0x00, 0xF8, 0x00, 0x7D, 0xF0, 0x00, 0xFB, 0xF0, 0x03, 0xF3, 0xF0, 0x0F, 
  0xC7, 0xF0, 0x3F, 0x87, 0xFF, 0xFE, 0x07, 0xFF, 0xF8, 0x03, 0xFF, 0xC0, 
  0x01, 0xFE, 0x00, 0x00, 0x00, 0x00, 0x3C, 0x03, 0xF0, 0x39, 0xC3, 0x83, 
  0x38, 0x1D, 0x80, 0x6C, 0x03, 0x70, 0x39, 0xC3, 0x87, 0x38, 0x1F, 0x80, 
  0x78, 0x00
};

const GFXglyph DegreeFontGlyphs[] PROGMEM = {
  {     0,  23,  26,  25,    1,  -25 },   // 0x43 'C'
  {     0,   0,   0,   0,    0,    0 },   // 0x44 'D'
  {     0,   0,   0,   0,    0,    0 },   // 0x45 'E'
  {     0,   0,   0,   0,    0,    0 },   // 0x46 'F'
  {     0,   0,   0,   0,    0,    0 },   // 0x47 'G'
  {     0,   0,   0,   0,    0,    0 },   // 0x48 'H'
  {     0,   0,   0,   0,    0,    0 },   // 0x49 'I'
  {     0,   0,   0,   0,    0,    0 },   // 0x4A 'J'
  {     0,   0,   0,   0,    0,    0 },   // 0x4B 'K'
  {     0,   0,   0,   0,    0,    0 },   // 0x4C 'L'
  {     0,   0,   0,   0,    0,    0 },   // 0x4D 'M'
  {     0,   0,   0,   0,    0,    0 },   // 0x4E 'N'
  {     0,   0,   0,   0,    0,    0 },   // 0x4F 'O'
  {     0,   0,   0,   0,    0,    0 },   // 0x50 'P'
  {     0,   0,   0,   0,    0,    0 },   // 0x51 'Q'
  {     0,   0,   0,   0,    0,    0 },   // 0x52 'R'
  {     0,   0,   0,   0,    0,    0 },   // 0x53 'S'
  {     0,   0,   0,   0,    0,    0 },   // 0x54 'T'
  {     0,   0,   0,   0,    0,    0 },   // 0x55 'U'
  {     0,   0,   0,   0,    0,    0 },   // 0x56 'V'
  {     0,   0,   0,   0,    0,    0 },   // 0x57 'W'
  {     0,   0,   0,   0,    0,    0 },   // 0x58 'X'
  {     0,   0,   0,   0,    0,    0 },   // 0x59 'Y'
  {     0,   0,   0,   0,    0,    0 },   // 0x5A 'Z'
  {     0,   0,   0,   0,    0,    0 },   // 0x5B '['
  {     0,   0,   0,   0,    0,    0 },   // 0x5C '\'
  {     0,   0,   0,   0,    0,    0 },   // 0x5D ']'
  {     0,   0,   0,   0,    0,    0 },   // 0x5E '^'
  {     0,   0,   0,   0,    0,    0 },   // 0x5F '_'
  {     0,   0,   0,   0,    0,    0 },   // 0x60 '`'
  {     0,   0,   0,   0,    0,    0 },   // 0x61 'a'
  {     0,   0,   0,   0,    0,    0 },   // 0x62 'b'
  {     0,   0,   0,   0,    0,    0 },   // 0x63 'c'
  {     0,   0,   0,   0,    0,    0 },   // 0x64 'd'
  {     0,   0,   0,   0,    0,    0 },   // 0x65 'e'
  {     0,   0,   0,   0,    0,    0 },   // 0x66 'f'
  {     0,   0,   0,   0,    0,    0 },   // 0x67 'g'
  {     0,   0,   0,   0,    0,    0 },   // 0x68 'h'
  {     0,   0,   0,   0,    0,    0 },   // 0x69 'i'
  {     0,   0,   0,   0,    0,    0 },   // 0x6A 'j'
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
};

const GFXfont DegreeFont PROGMEM = {
    (uint8_t *)DegreeFontBitmaps,   (GFXglyph *)DegreeFontGlyphs, 0x43, 0x6F,   42};

// Approx. 5175 bytes
