oprobst/compressor-monitor/kompressormonitor/DebugSerial.h

#ifndef DEBUGSERIAL_H_
#define DEBUGSERIAL_H_

#define DEBUG 1
#if DEBUG

#define SPRINTF(s, d)       \
    {                       \
        Serial.print(s, d); \
    }
#define SPRINTFLN(s, d)       \
    {                         \
        Serial.println(s, d); \
    }
#define SPRINT(s)        \
    {                    \
        Serial.print(s); \
    }
#define SPRINTLN(s)        \
    {                      \
        Serial.println(s); \
    }
#else
#define SPRINT(s)
#define SPRINTLN(s)
#endif
#define SERIALSPEED 115200

#endif
