oprobst/compressor-monitor/(commit log)

2022-11-11 Button to switch between config & main screen
2022-11-22 Added air pressure measure
2022-11-22 Merged Monitor and Compressor project
    [ionamen.csv]
2022-11-26 Render pressure also in maintenance mode
2022-11-28 Showing all current attributes in footer
2022-12-30 added doku; optimization on conn errors
    [ionamen.csv]
2024-04-22 Verzögerte Temperaturalarme gegen Fehldetektierung
2025-02-05 increased room temperature (7-10 degree)
2025-11-30 Abschaltung der Automatik zugefügt.
